lragnarsson/Ronny-the-robot/sensor_unit/sensor_unit/sensor_unit.h

/* 
 * sensor_unit.h
 * Ronny-the-robot/sensor_unit
 * ------------------------------
 * This file contains all functionality available in the sensor unit, 
 * including reading sensor values as well as sending and 
 * receiving messages to and from other modules.
 * ------------------------------ 
 * Author: J. Otterholm
 */ 

#ifndef SENSOR_UNIT_H_
#define SENSOR_UNIT_H_


#define F_CPU 20000000UL

/* Register defines */
#define TIMER0_B_NON_INV (1<<COM0B1) | (0<<COM0B0)
#define TIMER0_FAST_PWM_L (1<<WGM01) | (1<<WGM00)
#define TIMER0_FAST_PWM_H (0<<WGM02)
#define TIMER0_PRESCALE_1 (0<<CS02) | (0<<CS01) | (1<<CS00)
#define TIMER0_PRESCALE_1024 (1<<CS02) | (0<<CS01) | (1<<CS00)

#define TIMER1_CLEAR_ON_MATCH_H (0<<WGM13) | (1<<WGM12)
#define TIMER1_CLEAR_ON_MATCH_L (0<<WGM11) | (0<<WGM10)
#define TIMER1_PRESCALE_64 (0<<CS12) | (1<<CS11) | (1<<CS10)
#define TIMER1_MATCH_FREQUENCY_25HZ F_CPU / 25 / 64		// = 12500
#define TIMER1_INTERRUPT_ENABLE (1<<OCIE1A)

#define ADC_PRESCALE_128 (1<<ADEN) | (1<<ADPS2) | (1<<ADPS1) | (1<<ADPS0)	// 20 MHz / 128 = 156.25 kHz

#define INTERRUPT_INT0_INT1 (1<<INT1) | (1<<INT0)
#define INTERRUPT_INT0_INT1_RISING_EDGE (1<<ISC01) | (1<<ISC00) | (1<<ISC11) | (1<<ISC10)

#define AC_INTERRUPT_RISING_EDGE (1<<ACIE) | (1<<ACIS1) | (1<<ACIS0)

/* Port map */
#define ENC_L_B PINB0
#define ENC_R_B PINB1

#define REFL_REF PORTB4
#define REFL_ADC PINA5

/* Helpers */
#define ADC_NOT_COMPLETE !(ADCSRA & (1<<ADIF))

/* Values */
#define IR_SHORT_MIN 190
#define IR_SHORT_MAX 650
#define IR_LONG_MIN 140
#define IR_LONG_MAX 550
#define IR_NUM_SAMPLES 2

#define ENCODER_DISTANCE_SCALE 90
#define ENCODER_ROTATION_SCALE 165

#include <avr/io.h>
#include <avr/interrupt.h>
#include <util/delay.h>
#include <util/atomic.h>
#include <avr/pgmspace.h>

volatile uint16_t ir_sensors[5][IR_NUM_SAMPLES];
volatile int8_t encoder_left = 0;
volatile int8_t encoder_right = 0;
volatile uint8_t tape_found = 0;

const uint8_t ir_short_lut[IR_SHORT_MAX - IR_SHORT_MIN + 1] PROGMEM = { 234, 232, 230, 229, 227, 225, 223, 222, 220, 218, 216, 215, 213, 211, 210, 208, 206, 205, 203, 201, 200, 198, 197, 195, 194, 192, 191, 189, 188, 186, 185, 183, 182, 180, 179, 178, 176, 175, 174, 172, 171, 170, 168, 167, 166, 164, 163, 162, 161, 159, 158, 157, 156, 155, 153, 152, 151, 150, 149, 148, 147, 146, 144, 143, 142, 141, 140, 139, 138, 137, 136, 135, 134, 133, 132, 131, 130, 129, 128, 127, 126, 125, 125, 124, 123, 122, 121, 120, 119, 118, 118, 117, 116, 115, 114, 113, 113, 112, 111, 110, 110, 109, 108, 107, 107, 106, 105, 104, 104, 103, 102, 102, 101, 100, 99, 99, 98, 97, 97, 96, 96, 95, 94, 94, 93, 92, 92, 91, 91, 90, 89, 89, 88, 88, 87, 87, 86, 85, 85, 84, 84, 83, 83, 82, 82, 81, 81, 80, 80, 79, 79, 78, 78, 77, 77, 76, 76, 75, 75, 75, 74, 74, 73, 73, 72, 72, 71, 71, 71, 70, 70, 69, 69, 68, 68, 68, 67, 67, 66, 66, 66, 65, 65, 65, 64, 64, 63, 63, 63, 62, 62, 62, 61, 61, 61, 60, 60, 59, 59, 59, 58, 58, 58, 57, 57, 57, 56, 56, 56, 55, 55, 55, 55, 54, 54, 54, 53, 53, 53, 52, 52, 52, 51, 51, 51, 51, 50, 50, 50, 49, 49, 49, 48, 48, 48, 48, 47, 47, 47, 46, 46, 46, 46, 45, 45, 45, 44, 44, 44, 44, 43, 43, 43, 43, 42, 42, 42, 41, 41, 41, 41, 40, 40, 40, 40, 39, 39, 39, 38, 38, 38, 38, 37, 37, 37, 37, 36, 36, 36, 36, 35, 35, 35, 35, 34, 34, 34, 33, 33, 33, 33, 32, 32, 32, 32, 31, 31, 31, 31, 30, 30, 30, 30, 29, 29, 29, 29, 28, 28, 28, 28, 27, 27, 27, 27, 26, 26, 26, 26, 25, 25, 25, 25, 24, 24, 24, 24, 23, 23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
const uint16_t ir_long_lut_index_offset = IR_LONG_MIN;

uint8_t calibrate_reflectance_sensor();
void handle_recieved_message();
uint8_t send_distance_readings();
uint8_t send_odometry_readings();
void init_ir();
void init_reflectance();
void init_wheel_encoder();


#endif /* SENSOR_UNIT_H_ */
