lragnarsson/Ronny-the-robot/control_unit/control_unit/flood_fill.c

/* 
 * flood_fill.c
 * Ronny-the-robot/control_unit
 * ------------------------------
 * This file contains the algorithms for finding the shortest paths. 
 * ------------------------------ 
 * Author: L. Ragnarsson, E. Sköld
 */ 

#include <avr/io.h>
#include <util/delay.h>

#include "flood_fill.h"
#include "I2C.h"

uint8_t current_wavefront_size;
uint8_t new_wavefront_size;
coordinate wavefront_1[128];
coordinate wavefront_2[128];
coordinate* current_wavefront = &wavefront_1[0];
coordinate* new_wavefront = &wavefront_2[0];

/*
 * Swaps the pointer new_wavefront and current_wavefront.
 */
void swap_wavefronts(coordinate **wavefront1, coordinate **wavefront2)
{
	coordinate *temp = *wavefront1;
	*wavefront1 = *wavefront2;
	*wavefront2 = temp;
}

/*
 * Resets all the values in ff_map.
 */
void reset_flood_fill_values()
{
	for (int i = 0; i < MAP_SIZE; ++i)
		for(int j = 0; j < MAP_SIZE; ++j)
			ff_map[i][j] = FF_DEFAULT;
}

/*
 * Updates the current_rout variable with a route to the destination.
 * Calculates this route from data generated by one of the flood fill algotithms below.
 */
void calculate_route(coordinate destination)
{
	coordinate current_coordinate = destination;
	current_route[ff_map[destination.x][destination.y]] = ROUTE_END; 
	for(uint8_t i = ff_map[destination.x][destination.y] - 1; i != 255; --i)
	{
		/* Run straight ahead if possible */
		switch(current_route[i+1])
		{
			case NORTH:
				if(ff_map[current_coordinate.x + 1][current_coordinate.y] == i)
				{
					current_route[i] = NORTH;
					++current_coordinate.x;
					continue;
				}
				break;
			case EAST:
				if(ff_map[current_coordinate.x][current_coordinate.y - 1] == i)
				{
					current_route[i] = EAST;
					--current_coordinate.y;
					continue;
				}
				break;
			case SOUTH:
				if(ff_map[current_coordinate.x - 1][current_coordinate.y] == i)
				{
					current_route[i] = SOUTH;
					--current_coordinate.x;
					continue;
				}
				break;
			case WEST:
				if(ff_map[current_coordinate.x][current_coordinate.y + 1] == i)
				{
					current_route[i] = WEST;
					++current_coordinate.y;
					continue;
				}
				break;
			default:
				break;
		}
		
		if(ff_map[current_coordinate.x + 1][current_coordinate.y] == i) // Go NORTH?
		{
			current_route[i] = NORTH;
			++current_coordinate.x;	
		} else if(ff_map[current_coordinate.x][current_coordinate.y - 1] == i) // etc.
		{
			current_route[i] = EAST;
			--current_coordinate.y;
		} else if(ff_map[current_coordinate.x - 1][current_coordinate.y] == i)
		{
			current_route[i] = SOUTH;
			--current_coordinate.x;
		} else if(ff_map[current_coordinate.x][current_coordinate.y + 1] == i)
		{
			current_route[i] = WEST;
			++current_coordinate.y;
		}
	}
}

/*
 * Floods the maze on known paths until a destination is reached.
 */
void flood_fill_to_destination(coordinate destination) {
	reset_flood_fill_values();
	*current_wavefront = current_position;
	current_wavefront_size = 1;
	
	uint8_t distance = 0;
	while(1)
	{
		new_wavefront_size = 0;
		for(int i = 0; i < current_wavefront_size; ++i)
		{
			uint8_t x_coord = (current_wavefront + i)->x;
			uint8_t y_coord = (current_wavefront + i)->y;
			ff_map[x_coord][y_coord] = distance;
			if(x_coord == destination.x && y_coord == destination.y)
			{
				calculate_route(destination);
				return;
			}
			
			if(map[x_coord - 1][y_coord] == NOT_WALL && ff_map[x_coord - 1][y_coord] == FF_DEFAULT) // NORTH
			{
				*(new_wavefront + new_wavefront_size) = (coordinate){x_coord - 1, y_coord};
				++new_wavefront_size;		
			}
			if(map[x_coord][y_coord + 1] == NOT_WALL && ff_map[x_coord][y_coord + 1] == FF_DEFAULT) // EAST
			{
				*(new_wavefront + new_wavefront_size) = (coordinate){x_coord, y_coord + 1};
				++new_wavefront_size;
			}
			if(map[x_coord + 1][y_coord] == NOT_WALL && ff_map[x_coord + 1][y_coord] == FF_DEFAULT) // SOUTH
			{
				*(new_wavefront + new_wavefront_size) = (coordinate){x_coord + 1, y_coord};
				++new_wavefront_size;
			}
			if(map[x_coord][y_coord - 1] == NOT_WALL && ff_map[x_coord][y_coord - 1] == FF_DEFAULT) // WEST
			{
				*(new_wavefront + new_wavefront_size) = (coordinate){x_coord, y_coord - 1};
				++new_wavefront_size;
			}
		}
		/* Route to destination not found */
		if(new_wavefront_size == 0) 
		{
			current_route[0] = ROUTE_END;
			return;
		}
		++distance;
		current_wavefront_size = new_wavefront_size;
		swap_wavefronts(&current_wavefront, &new_wavefront);
	}
}

/*
 * Floods the maze on known paths until an unmapped square is reached.
 */
void flood_fill_to_unmapped() {
	reset_flood_fill_values();
	*current_wavefront = current_position;
	current_wavefront_size = 1;  
	
	uint8_t distance = 0;
	while(1)
	{
		new_wavefront_size = 0;
		for(int i = 0; i < current_wavefront_size; ++i)
		{
			uint8_t x_coord = (current_wavefront + i)->x;
			uint8_t y_coord = (current_wavefront + i)->y;
			
			ff_map[x_coord][y_coord] = distance;
			
			/* Don't let the flood fill escape into the void! */
			if (x_coord == 17 && y_coord == 16)
				continue;
			
			if(map[x_coord][y_coord] == UNMAPPED)
			{
				calculate_route((coordinate){ x_coord, y_coord });
				return;
			}
				
			if((map[x_coord - 1][y_coord] == NOT_WALL || map[x_coord - 1][y_coord] == UNMAPPED) && ff_map[x_coord - 1][y_coord] == FF_DEFAULT) // NORTH
			{
				*(new_wavefront + new_wavefront_size) = (coordinate){x_coord - 1, y_coord};
				++new_wavefront_size;
			}
			if((map[x_coord][y_coord + 1] == NOT_WALL || map[x_coord][y_coord + 1] == UNMAPPED) && ff_map[x_coord][y_coord + 1] == FF_DEFAULT) // EAST
			{
				*(new_wavefront + new_wavefront_size) = (coordinate){x_coord, y_coord + 1};
				++new_wavefront_size;
			}
			if((map[x_coord + 1][y_coord] == NOT_WALL || map[x_coord + 1][y_coord] == UNMAPPED) && ff_map[x_coord + 1][y_coord] == FF_DEFAULT) // SOUTH
			{
				*(new_wavefront + new_wavefront_size) = (coordinate){x_coord + 1, y_coord};
				++new_wavefront_size;
			}
			if((map[x_coord][y_coord - 1] == NOT_WALL || map[x_coord][y_coord - 1] == UNMAPPED) && ff_map[x_coord][y_coord - 1] == FF_DEFAULT) // WEST
			{
				*(new_wavefront + new_wavefront_size) = (coordinate){x_coord, y_coord - 1};
				++new_wavefront_size;
			}
		}
		/* Route to destination not found */
		if(new_wavefront_size == 0) 
		{
			current_route[0] = ROUTE_END;
			return;
		}
		++distance;
		current_wavefront_size = new_wavefront_size;
		swap_wavefronts(&current_wavefront, &new_wavefront);				
	}
}

/*
 * Floods the maze on known AND unexplored paths to find an optimistic guess for a shortest route back to the start.
 */
void flood_fill_home_optimistic(coordinate origin) {
	reset_flood_fill_values();
	*current_wavefront = origin;
	current_wavefront_size = 1;
	uint8_t distance = 0;
	uint8_t duplicate = 0;
	while(1)
	{
		new_wavefront_size = 0;
		for(int i = 0; i < current_wavefront_size; ++i)
		{
			uint8_t x_coord = (current_wavefront + i)->x;
			uint8_t y_coord = (current_wavefront + i)->y;
			ff_map[x_coord][y_coord] = distance;
			
			if(x_coord == start_position.x && y_coord == start_position.y)
			{
				calculate_route(start_position);
				return;
			}
						
			if(map[x_coord - 1][y_coord] != WALL && ff_map[x_coord - 1][y_coord] == FF_DEFAULT) // NORTH
			{
				duplicate = 0;
				for (uint8_t j = 1; j <= new_wavefront_size; ++j)
					if ((new_wavefront + new_wavefront_size - j)->x == x_coord - 1 && (new_wavefront + new_wavefront_size - j)->y == y_coord)
					{
						duplicate = 1;
						break;
					}
				if (!duplicate)
				{
					*(new_wavefront + new_wavefront_size) = (coordinate){x_coord - 1, y_coord};
					++new_wavefront_size;
				}
			}
			if(map[x_coord][y_coord + 1] != WALL && ff_map[x_coord][y_coord + 1] == FF_DEFAULT) // EAST
			{
				duplicate = 0;
				for (uint8_t j = 1; j <= new_wavefront_size; ++j)
					if ((new_wavefront + new_wavefront_size - j)->x == x_coord && (new_wavefront + new_wavefront_size - j)->y == y_coord + 1)
					{
						duplicate = 1;
						break;
					}
					if (!duplicate)
					{
						*(new_wavefront + new_wavefront_size) = (coordinate){x_coord, y_coord + 1};
						++new_wavefront_size;
					}
			}
			if(map[x_coord + 1][y_coord] != WALL && ff_map[x_coord + 1][y_coord] == FF_DEFAULT) // SOUTH
			{
				duplicate = 0;
				for (uint8_t j = 1; j <= new_wavefront_size; ++j)
					if ((new_wavefront + new_wavefront_size - j)->x == x_coord + 1 && (new_wavefront + new_wavefront_size - j)->y == y_coord)
					{
						duplicate = 1;
						break;
					}
				if (!duplicate)
				{
					*(new_wavefront + new_wavefront_size) = (coordinate){x_coord + 1, y_coord};
					++new_wavefront_size;
				}
			}
			if(map[x_coord][y_coord - 1] != WALL && ff_map[x_coord][y_coord - 1] == FF_DEFAULT) // WEST
			{
				duplicate = 0;
				for (uint8_t j = 1; j <= new_wavefront_size; ++j)
					if ((new_wavefront + new_wavefront_size - j)->x == x_coord && (new_wavefront + new_wavefront_size - j)->y == y_coord - 1)
					{
						duplicate = 1;
						break;
					}
				if (!duplicate)
				{
					*(new_wavefront + new_wavefront_size) = (coordinate){x_coord, y_coord - 1};
					++new_wavefront_size;
				}
			}
		}
		/* Route to destination not found */
		if(new_wavefront_size == 0) 
		{
			current_route[0] = ROUTE_END;
			return;
		}
		++distance;
		current_wavefront_size = new_wavefront_size;
		swap_wavefronts(&current_wavefront, &new_wavefront);
	}
}
