lragnarsson/Ronny-the-robot/(commit log)

2015-03-23 Added documentation
    [Tidplan1.0.xlsx.xlsx]
2015-03-26 Added first version of the control- and sensor-unit.
2015-04-01 UART and I2C MM started
2015-04-01 i2c test
2015-04-14 Split into several files, added acceleration to avoid wheel spin, added map representation.
    [bus_communication.c, bus_communication.h, control_system.c, control_system.h, control_unit.c, control_unit.h, map.c, map.h]
2015-04-15 Some small fixes on I2C and manual mode
    [I2C.c, I2C.h, bus_communication.c, bus_communication.h, control_unit.c]
2015-04-15 started on flood fill, and some other fixes
    [bus_communication.c, bus_communication.h, control_unit.c, flood_fill.c, flood_fill.h, map.c, map.h]
2015-04-16 communication for sensor unit
2015-04-17 Uart changed
2015-04-17 Added seat belts to the bus
2015-04-17 Some tests with wheel encoders
2015-04-22 Fixed header names in code
    [bus_communication.c, control_unit.c, sensor_unit.c]
2015-04-22 Some small fixes and preperation for control-system test.
    [bus_communication.c, control_system.c, control_unit.c, flood_fill.c, map.c, sensor_unit.c]
2015-04-22 Working flood fill, working wheel encoder usage for distance/angle remaining
2015-04-24 sensorvärden i nya gui
2015-04-25 Fler cases + definitioner av cases, sensorvärden
2015-04-26 sensorvärden på robot
2015-04-28 Some more fixes to retrieve and flood fill stuff
    [control_unit.c, flood_fill.c, map.c, map.h]
2015-04-29 encoder scaling
2015-04-29 Fixed optimistic flood fill
    [control_unit.c, flood_fill.c, map.c]
2015-04-29 deaccleration and encoder calibration
2015-04-29 fixup! deaccleration and encoder calibration
    [bus_communication.c, communication_unit.c, control_system.c, control_unit.c, control_unit.h, map.c, sensor_unit.c]
2015-05-01 bättre reaktionstid på sensorvärden
2015-05-06 Fixed busbuffer and made control system work in intersections
    [I2C.c, bus_communication.c, bus_communication.h, communication_unit.c, control_system.c, control_system.h, control_unit.c, control_unit.h]
2015-05-07 Merge branch 'master' of https://github.com/lragnarsson/Ronny-the-robot
    Conflicts:
    communication_unit/communication_unit/I2C.c
    communication_unit/communication_unit/communication_unit.c
    control_unit/control_unit/I2C.c
    sensor_unit/sensor_unit/I2C.c
    kod för Kartritning och flyttning för Wall, körbar,nödst gjord
2015-05-07 Some tweaks and fixes for the search state
    [bus_communication.c, communication_unit.c, control_system.c, control_unit.c, map.c, map.h, sensor_unit.c, sensor_unit.h]
2015-05-13 Major (MAJOR) bug fix in mapping walls
    [control_unit.c, map.c]
2015-05-15 motor trim and basic claw functionality
2015-05-17 outline clawstates
2015-05-18 working claw
2015-05-19 current position
2015-05-21 Reworked return_state, will now find sortest path home
    [control_system.c, control_unit.c, flood_fill.c]
2015-05-22 improved uart with multiple bytes from pc
2015-05-22 multiple tries to send tape found from sensor unit
2015-05-27 Removed i2c_test
2015-05-27 cleaning cleaning and commenting correctly PC
    [PC_unit.h]
2015-05-27 sensor_unit spelling misstake
2015-05-27 I2C update
2015-06-03 Finished documentation
    [Tidplan1.0.xlsx]
